Davey09/NEMA23-Stepper-Controller-PCB/images/pcb_render_isometric_bottom.png

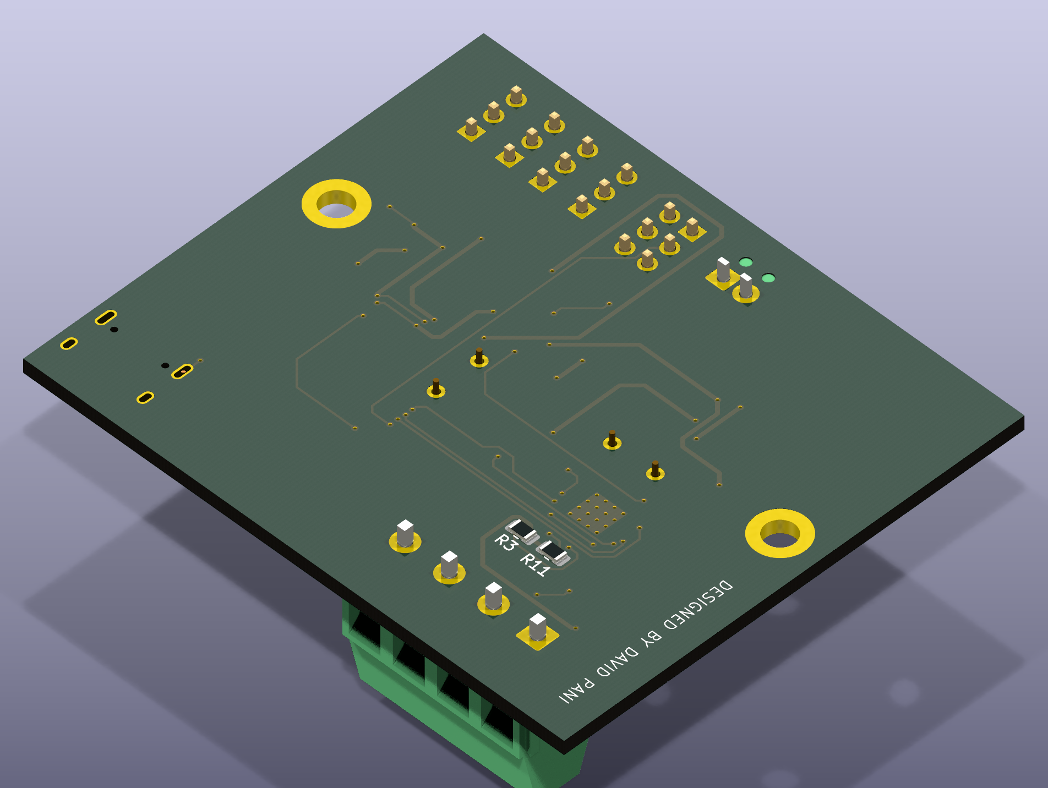
images/pcb_render_isometric_bottom.png
