Davey09/NEMA23-Stepper-Controller-PCB/fabrication/BOM.csv

Reference | Value | Footprint | Qty
C1-C3,C6,C9-C12,C14,C15,C18 | 100nF | Capacitor_SMD:C_0805_2012Metric | 11
C4,C5 | 22pF | Capacitor_SMD:C_0805_2012Metric | 2
C7,C8,C16,C17 | 4.7uF | Capacitor_Tantalum_SMD:CP_EIA-3528-15_AVX-H | 4
C13 | 100μF | Capacitor_SMD:C_0805_2012Metric | 1
C19-C22 | 160nF | Capacitor_SMD:C_0805_2012Metric | 4
D1 | US1G | Diode_SMD:D_SMA | 1
D2,D3 | LED | LED_SMD:LED_0805_2012Metric | 2
D5 | RX | LED_SMD:LED_0805_2012Metric | 1
D6 | PWR | LED_SMD:LED_0805_2012Metric | 1
D7 | TX | LED_SMD:LED_0805_2012Metric | 1
J2 | ISP | Connector_PinHeader_2.54mm:PinHeader_2x03_P2.54mm_Vertical | 1
J3 | DIGITAL_1 | Connector_PinHeader_2.54mm:PinHeader_1x03_P2.54mm_Vertical | 1
J4 | DIGITAL_2 | Connector_PinHeader_2.54mm:PinHeader_1x03_P2.54mm_Vertical | 1
J5 | ANALOG_1 | Connector_PinHeader_2.54mm:PinHeader_1x03_P2.54mm_Vertical | 1
J6 | Power input | TerminalBlock_Phoenix:TerminalBlock_Phoenix_MPT-0,5-2-2.54_1x02_P2.54mm_Horizontal | 1
J7 | Stepper_motor | TerminalBlock_Phoenix:TerminalBlock_Phoenix_MKDS-1,5-4_1x04_P5.00mm_Horizontal | 1
J8 | ANALOG_2 | Connector_PinHeader_2.54mm:PinHeader_1x03_P2.54mm_Vertical | 1
J9 | USB_C_Receptacle_USB2.0_16P | Connector_USB:USB_C_Receptacle_XKB_U262-16XN-4BVC11 | 1
R1,R2,R16 | 10kΩ | Resistor_SMD:R_0805_2012Metric | 3
R3,R11 | 0.11Ω | Resistor_SMD:R_0805_2012Metric | 2
R4,R5,R12-R15 | 1kΩ | Resistor_SMD:R_0805_2012Metric | 6
R6-R8 | 300Ω | Resistor_SMD:R_0805_2012Metric | 3
R9,R10 | 5.1kΩ | Resistor_SMD:R_0805_2012Metric | 2
R17 | 6.2kΩ | Resistor_SMD:R_0805_2012Metric | 1
SW1 | SW_Push | Button_Switch_SMD:SW_SPST_Omron_B3FS-100xP | 1
U1 | ATmega328-A | Package_QFP:TQFP-32_7x7mm_P0.8mm | 1
U2 | NCP1117-5.0_SOT223 | Package_TO_SOT_SMD:SOT-223-3_TabPin2 | 1
U3 | FT232RL | Package_SO:SSOP-28_5.3x10.2mm_P0.65mm | 1
U5 | TMC2209-LA | Package_DFN_QFN:VQFN-28-1EP_5x5mm_P0.5mm_EP3.7x3.7mm_ThermalVias | 1
Y1,Y2 | 16MHz | Crystal:Crystal_HC49-4H_Vertical | 2
