Davey09/NEMA23-Stepper-Controller-PCB/docs/Schematic.pdf

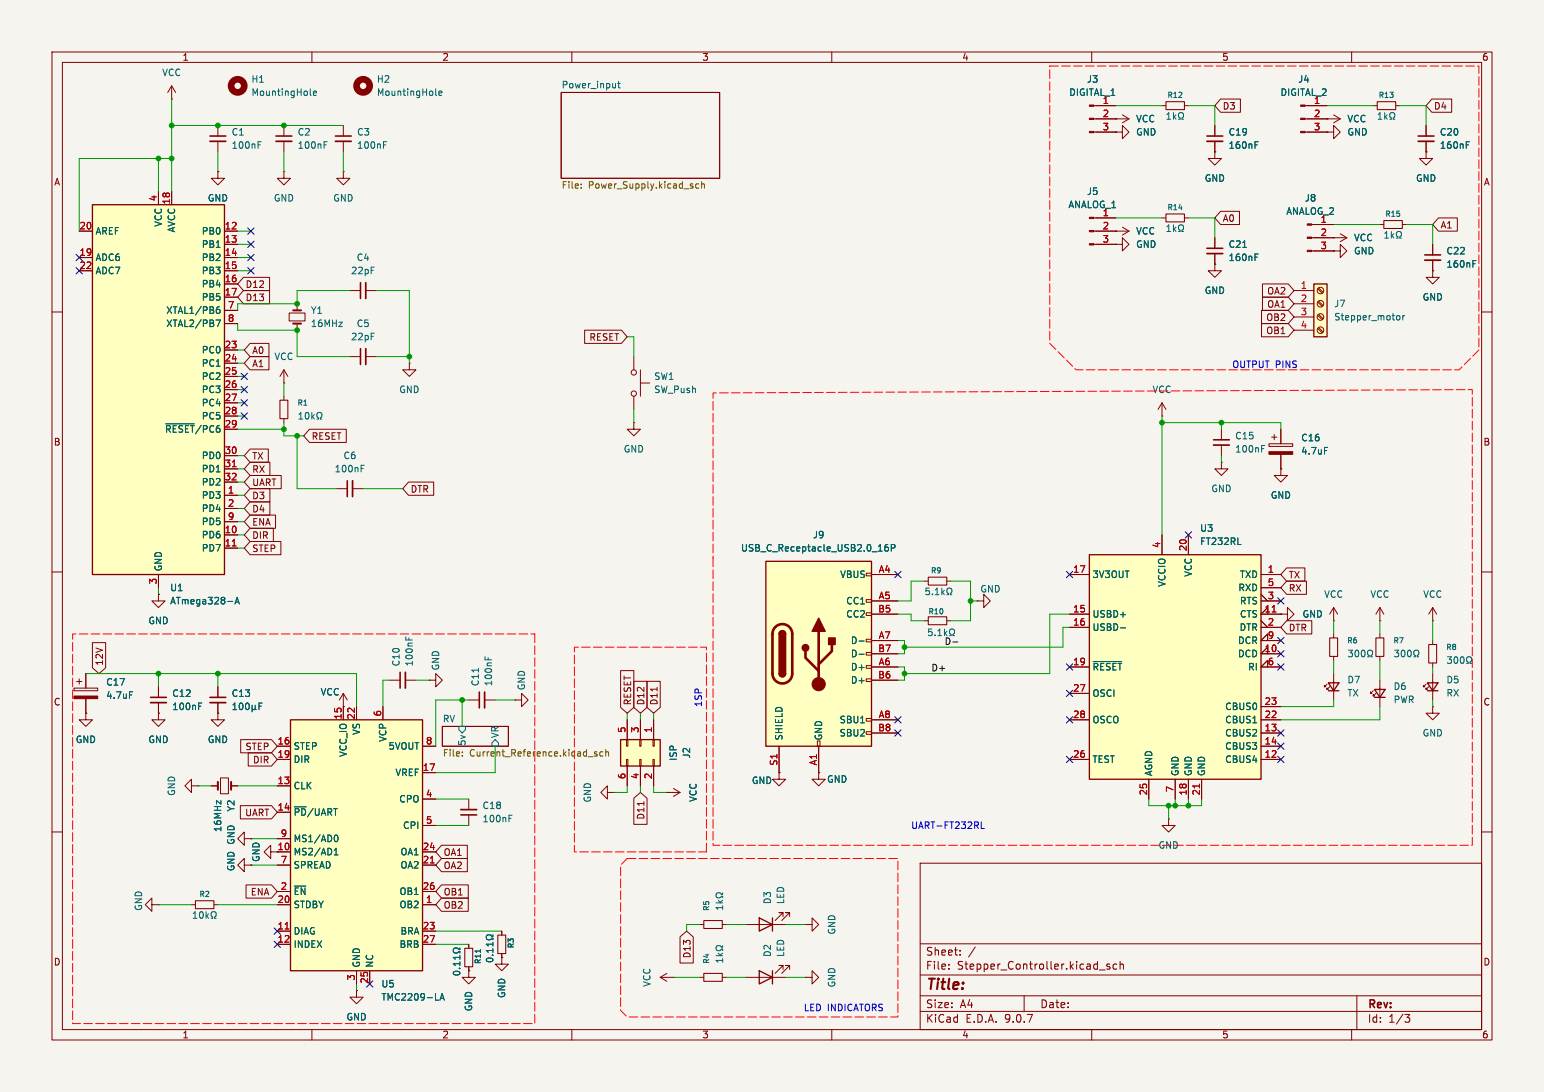
[picture p5: page 1]

100nFH1 MountingHole VCC GND GND

3 AVCC 18 PB0 12 PB1 13 PB2 14 PB3 15 PB4 16 PB5 17 XTAL1/PB6 7 XTAL2/PB7 8 PC0 23 PC1 24 PC2 25 PC3 26 PC4 27 PC5 28 ~{RESET}/PC629 PD0 30 PD1 31 PD2 32 PD3 1 PD4 2 PD5 9 PD6 10 PD7 11 R3 R11 þÿ0.11© þÿ0.11© VCC ISPJ2

7 VCC 20 GND 18 GND 21 TXD 1 RXD 5 RTS 3 CTS 11 DTR 2 DCR 9 DCD 10 RI 6 CBUS0 23 CBUS1 22 CBUS2 13 CBUS3 14 CBUS4 12 U3 FT232RL C16

7 VCC 20 GND 18 GND 21 TXD 1 RXD 5 RTS 3 CTS 11 DTR 2 DCR 9 DCD 10 RI 6 CBUS0 23 CBUS1 22 CBUS2 13 CBUS3 14 CBUS4 12 C16

Id: 1/3 Title: File: Stepper_Controller.kicad_sch Sheet: /

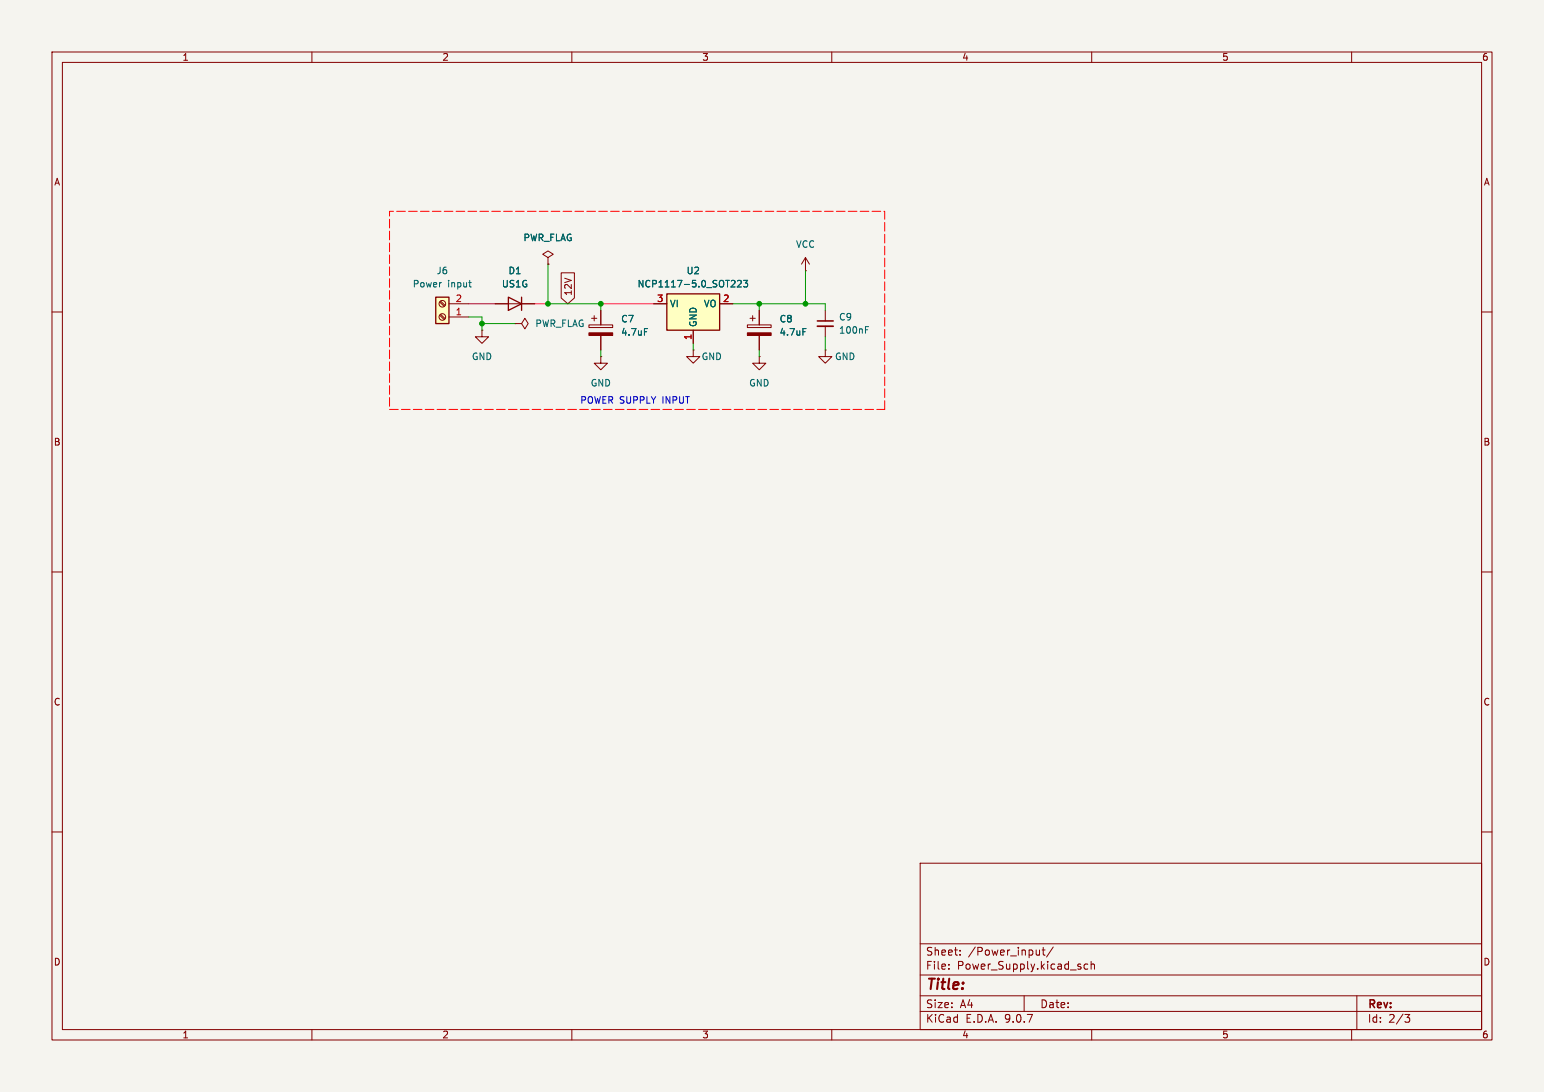
[picture p6: page 2]

Id: 2/3 Title: File: Power_Supply.kicad_sch Sheet: /Power_input/

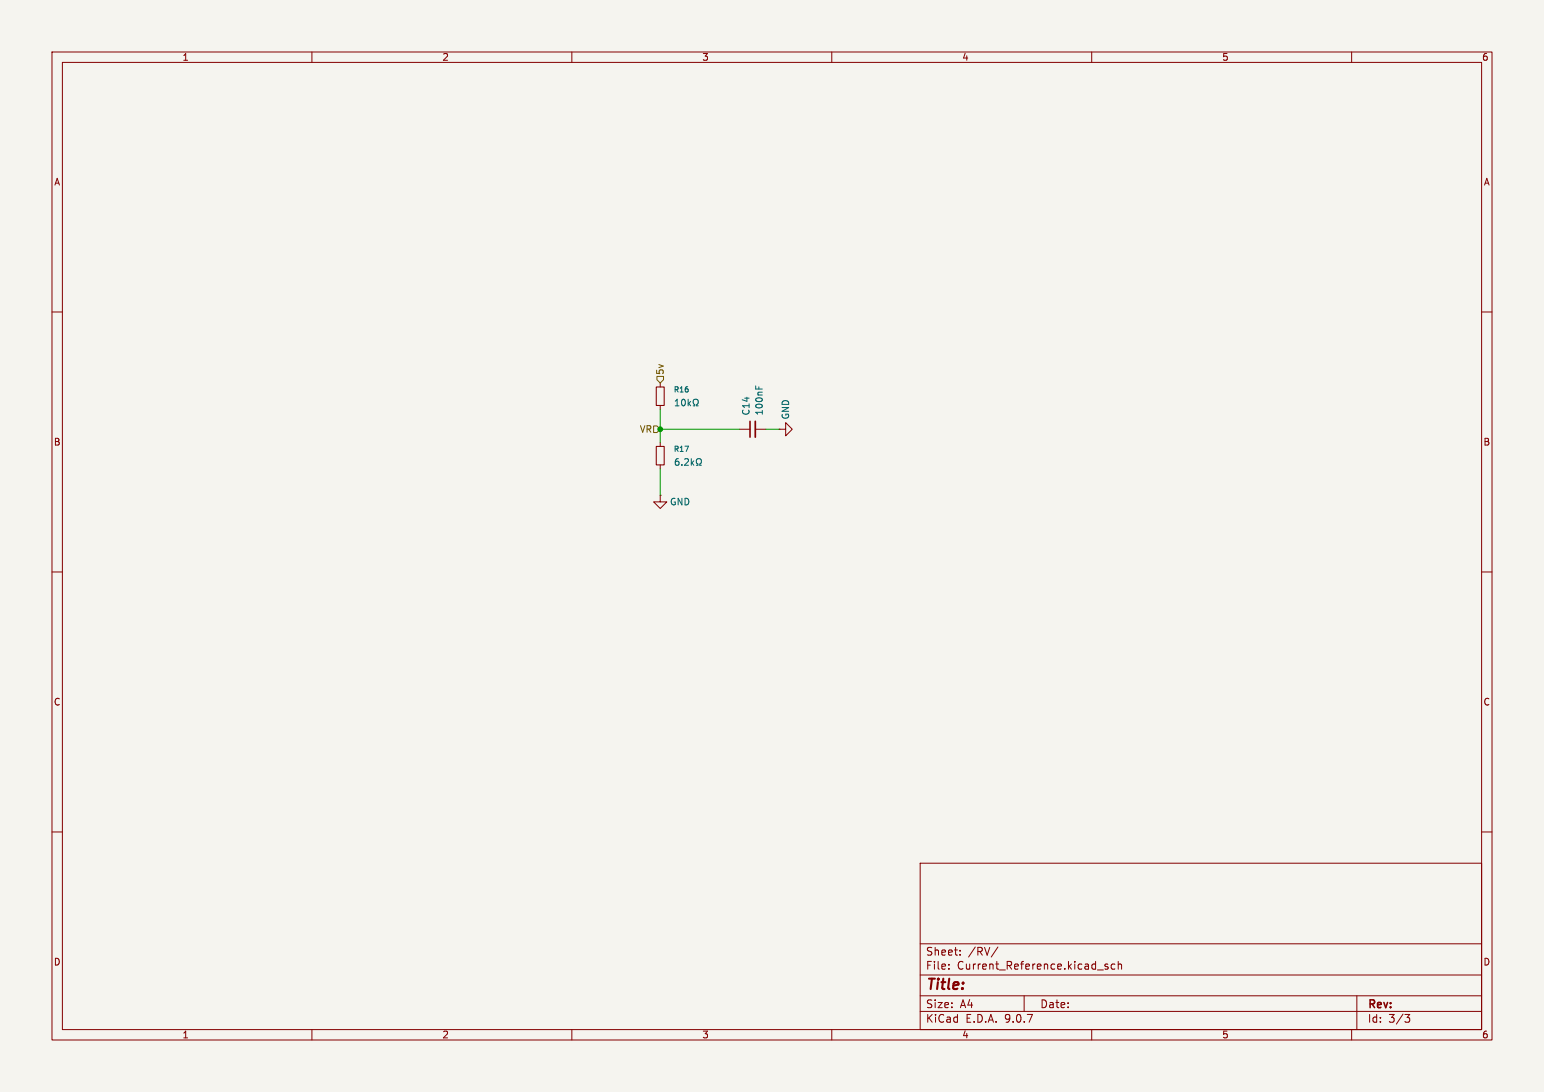
[picture p7: page 3]

Id: 3/3 Title: File: Current_Reference.kicad_sch Sheet: /RV/ GND
