Davey09/NEMA23-Stepper-Controller-PCB/hardware/Stepper_Controller.kicad_pcb

## KiCad design hardware/Stepper_Controller.kicad_pcb (2026-11-10)

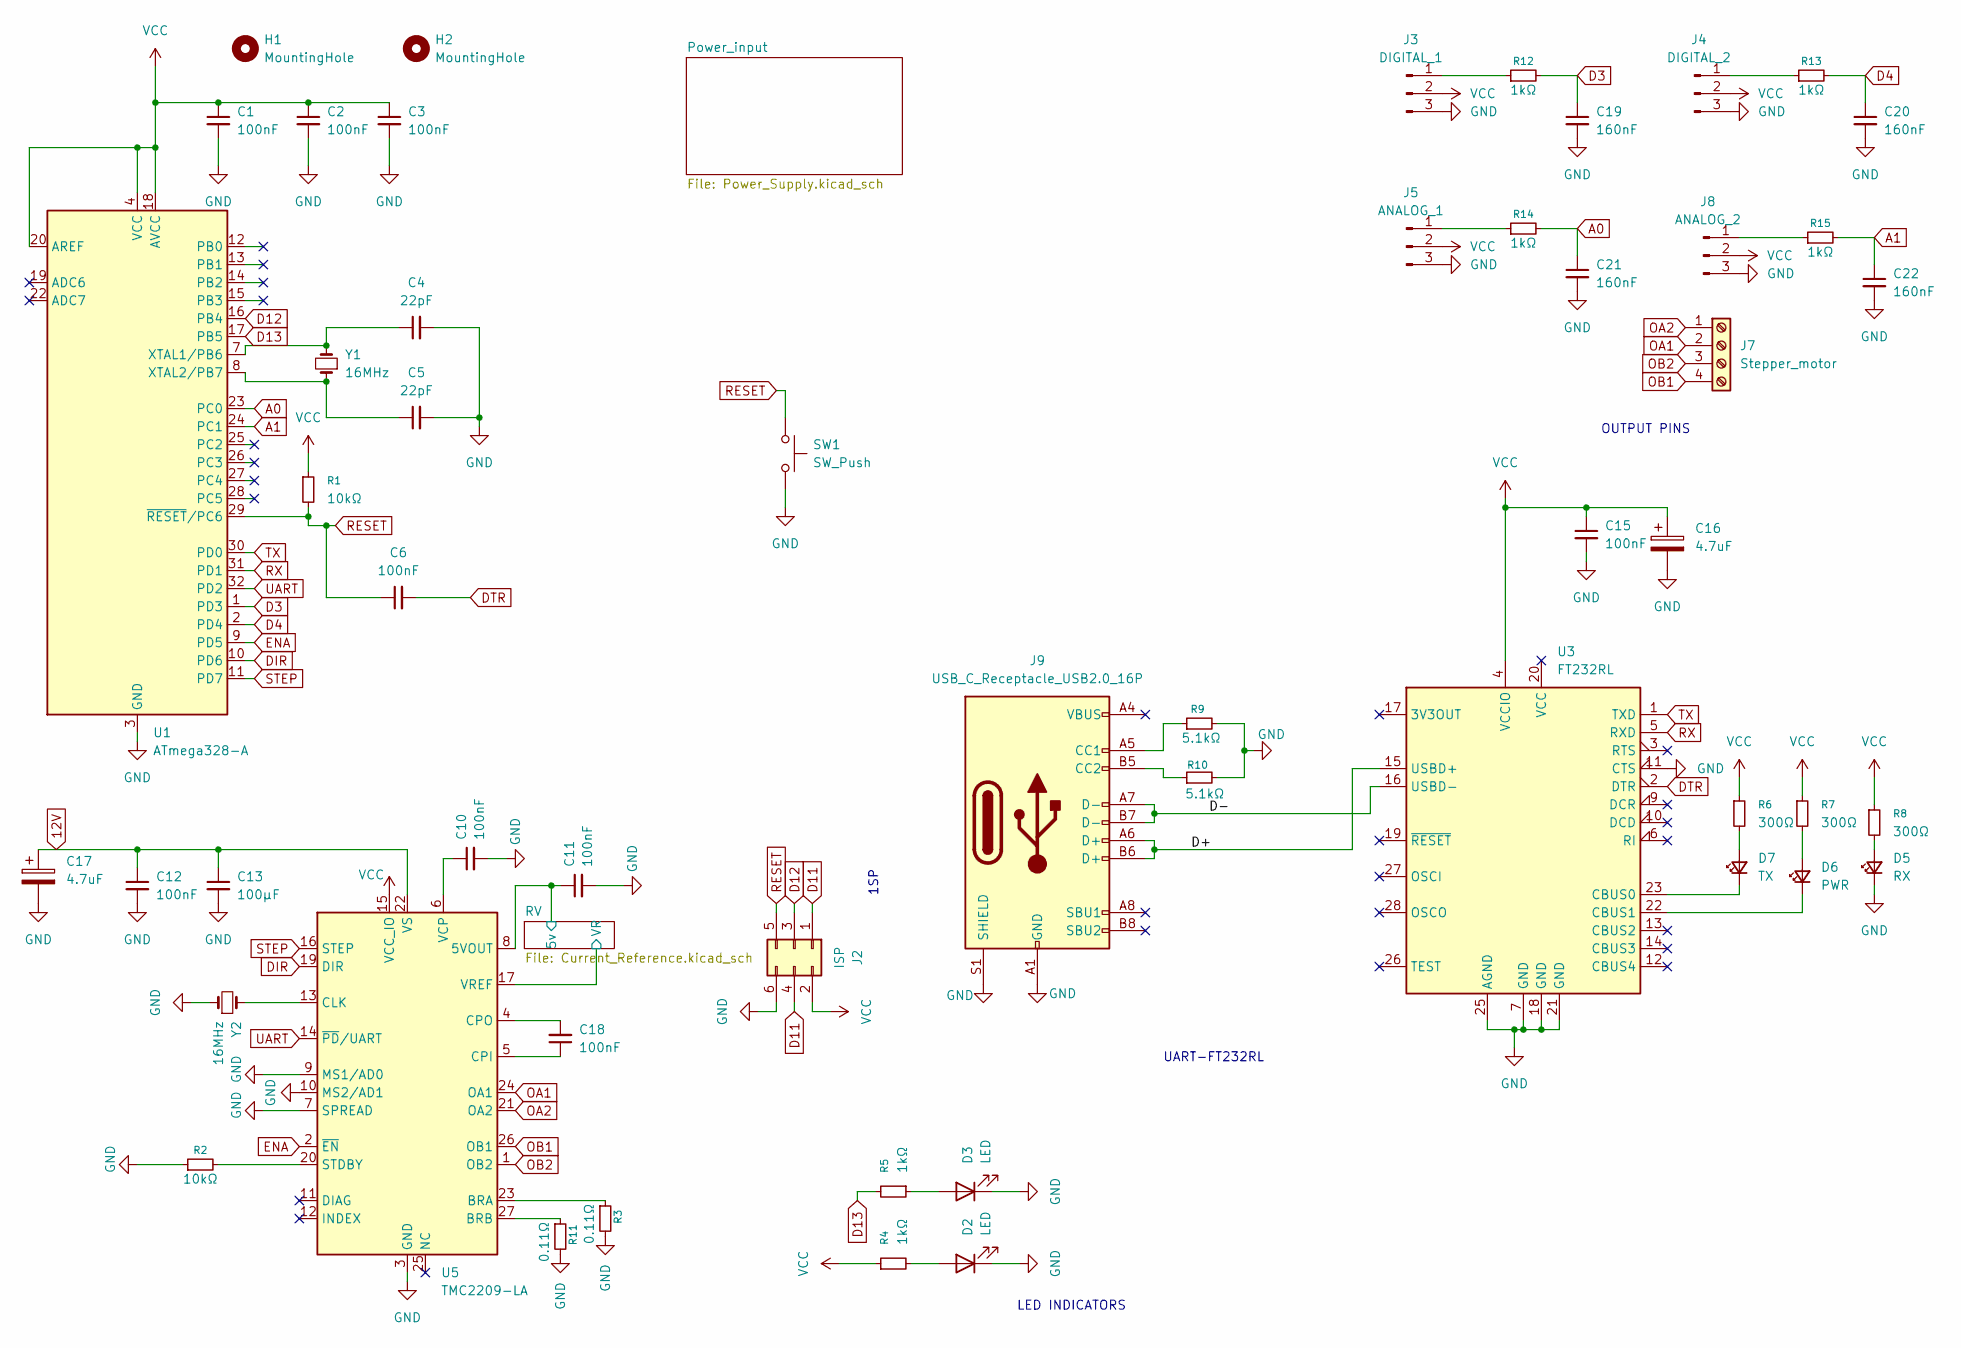
[picture p8: schematic Stepper_Controller.kicad_sch]

Parts:
C1, C2, C3, C6, C10, C11, C12, C15, C18: 100nF; C_0805_2012Metric
C4, C5: 22pF; C_0805_2012Metric
C13: 100μF; C_0805_2012Metric
C16, C17: 4.7uF; CP_EIA-3528-15_AVX-H
C19, C20, C21, C22: 160nF; C_0805_2012Metric
D2, D3: LED; LED_0805_2012Metric
D5: RX; LED_0805_2012Metric
D6: PWR; LED_0805_2012Metric
D7: TX; LED_0805_2012Metric
H1, H2: MountingHole; MountingHole_3.2mm_M3_DIN965_Pad
J2: ISP; PinHeader_2x03_P2.54mm_Vertical
J3: DIGITAL_1; PinHeader_1x03_P2.54mm_Vertical
J4: DIGITAL_2; PinHeader_1x03_P2.54mm_Vertical
J5: ANALOG_1; PinHeader_1x03_P2.54mm_Vertical
J7: Stepper_motor; TerminalBlock_Phoenix_MKDS-1,5-4_1x04_P5.00mm_Horizontal
J8: ANALOG_2; PinHeader_1x03_P2.54mm_Vertical
J9: USB_C_Receptacle_USB2.0_16P; USB_C_Receptacle_XKB_U262-16XN-4BVC11
R1, R2: 10kΩ; R_0805_2012Metric
R3, R11: 0.11Ω; R_0805_2012Metric
R4, R5, R12, R13, R14, R15: 1kΩ; R_0805_2012Metric
R6, R7, R8: 300Ω; R_0805_2012Metric
R9, R10: 5.1kΩ; R_0805_2012Metric
SW1: SW_Push; SW_SPST_Omron_B3FS-100xP
U1: ATmega328-A; TQFP-32_7x7mm_P0.8mm
U3: FT232RL; SSOP-28_5.3x10.2mm_P0.65mm
U5: TMC2209-LA; VQFN-28-1EP_5x5mm_P0.5mm_EP3.7x3.7mm_ThermalVias
Y1, Y2: 16MHz; Crystal_HC49-4H_Vertical

Connections:
12V: C12.1, C13.1, C17.1, U5.22 (VS), U5.28 (VS); also elsewhere on the board
/D+: J9.A6 (D+), J9.B6 (D+), U3.15 (USBD+)
/D-: J9.A7 (D-), J9.B7 (D-), U3.16 (USBD-)
/RV/5v: C11.1, U5.8 (5VOUT); also elsewhere on the board
/RV/VR: U5.17 (VREF); also elsewhere on the board
A0: C21.1, R14.2, U1.23 (PC0)
A1: C22.1, R15.2, U1.24 (PC1)
D3: C19.1, R12.2, U1.1 (PD3)
D4: C20.1, R13.2, U1.2 (PD4)
D11: J2.1, J2.4
D12: J2.3, U1.16 (PB4)
D13: R5.2, U1.17 (PB5)
DIR: U1.10 (PD6), U5.19 (DIR)
DTR: C6.2, U3.2 (DTR)
ENA: U1.9 (PD5), U5.2 (~EN)
GND: C1.2, C2.2, C3.2, C4.2, C5.2, C10.2, C11.2, C12.2, C13.2, C15.2, C16.2, C17.2, C19.2, C20.2, C21.2, C22.2, D2.1 (K), D3.1 (K), D5.1 (K), J2.6, J3.3, J4.3, J5.3, J8.3, J9.A1 (GND), J9.A12 (GND), J9.B1 (GND), J9.B12 (GND), J9.S1 (SHIELD), R2.1, R3.2, R9.2, R10.2, R11.2, SW1.2, U1.3 (GND), U1.5 (GND), U1.21 (GND), U3.7 (GND), U3.11 (CTS), U3.18 (GND), U3.21 (GND), U3.25 (AGND), U5.3 (GND), U5.7 (SPREAD), U5.9 (MS1/AD0), U5.10 (MS2/AD1), U5.18 (GND), U5.29 (GND), Y2.1; also elsewhere on the board
unnamed: D2.2 (A), R4.2
unnamed: D3.2 (A), R5.1
unnamed: D5.2 (A), R8.2
unnamed: D6.2 (A), R7.2
unnamed: D6.1 (K), U3.22 (CBUS1)
unnamed: D7.2 (A), R6.2
unnamed: D7.1 (K), U3.23 (CBUS0)
unnamed: J3.1, R12.1
unnamed: J4.1, R13.1
unnamed: J5.1, R14.1
unnamed: J8.1, R15.1
unnamed: J9.A5 (CC1), R9.1
unnamed: J9.B5 (CC2), R10.1
unnamed: C4.1, U1.7 (XTAL1/PB6), Y1.2
unnamed: C5.1, U1.8 (XTAL2/PB7), Y1.1
unnamed: R3.1, U5.23 (BRA)
unnamed: R11.1, U5.27 (BRB)
unnamed: U5.13 (CLK), Y2.2
unnamed: C18.1, U5.5 (CPI)
unnamed: C18.2, U5.4 (CPO)
unnamed: R2.2, U5.20 (STDBY)
unnamed: C10.1, U5.6 (VCP)
OA1: J7.2, U5.24 (OA1)
OA2: J7.1, U5.21 (OA2)
OB1: J7.4, U5.26 (OB1)
OB2: J7.3, U5.1 (OB2)
RESET: C6.1, J2.5, R1.2, SW1.1, U1.29 (~RESET/PC6)
RX: U1.31 (PD1), U3.5 (RXD)
STEP: U1.11 (PD7), U5.16 (STEP)
TX: U1.30 (PD0), U3.1 (TXD)
UART: U1.32 (PD2), U5.14 (~PD/UART)
VCC: C1.1, C2.1, C3.1, C15.1, C16.1, J2.2, J3.2, J4.2, J5.2, J8.2, R1.1, R4.1, R6.1, R7.1, R8.1, U1.4 (VCC), U1.6 (VCC), U1.18 (AVCC), U1.20 (AREF), U3.4 (VCCIO), U5.15 (VCC_IO); also elsewhere on the board

Notes on the sheet:
OUTPUT PINS
LED INDICATORS
1SP
UART-FT232RL

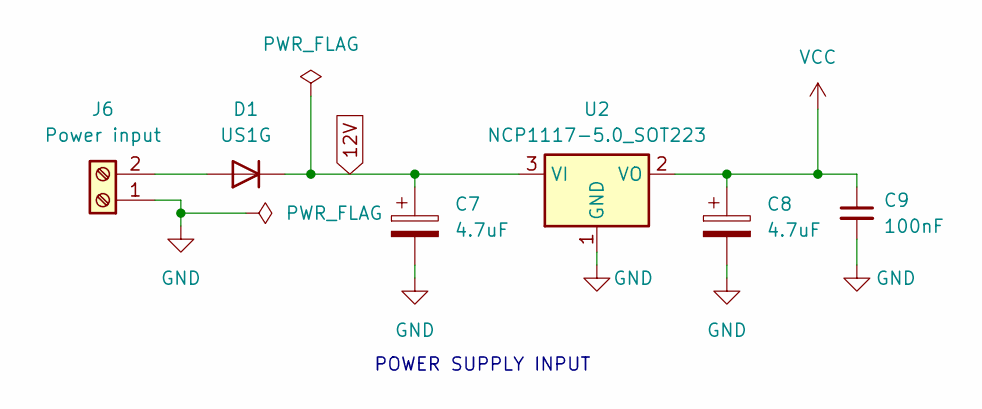
[picture p9: schematic Power_Supply.kicad_sch]

Parts:
C7, C8: 4.7uF; CP_EIA-3528-15_AVX-H
C9: 100nF; C_0805_2012Metric
D1: US1G; D_SMA
J6: Power input; TerminalBlock_Phoenix_MPT-0,5-2-2.54_1x02_P2.54mm_Horizontal
U2: NCP1117-5.0_SOT223; SOT-223-3_TabPin2

Connections:
12V: C7.1, D1.1 (K), U2.3 (VI); also elsewhere on the board
GND: C7.2, C8.2, C9.2, J6.1, U2.1 (GND); also elsewhere on the board
unnamed: D1.2 (A), J6.2
VCC: C8.1, C9.1, U2.2 (VO); also elsewhere on the board

Notes on the sheet:
POWER SUPPLY INPUT

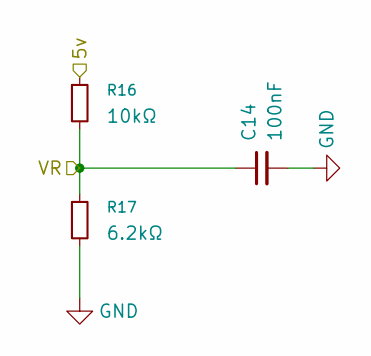
[picture p10: schematic Current_Reference.kicad_sch]

Parts:
C14: 100nF; C_0805_2012Metric
R16: 10kΩ; R_0805_2012Metric
R17: 6.2kΩ; R_0805_2012Metric

Connections:
/RV/5v: R16.1; also elsewhere on the board
/RV/VR: C14.1, R16.2, R17.1; also elsewhere on the board
GND: C14.2, R17.2; also elsewhere on the board

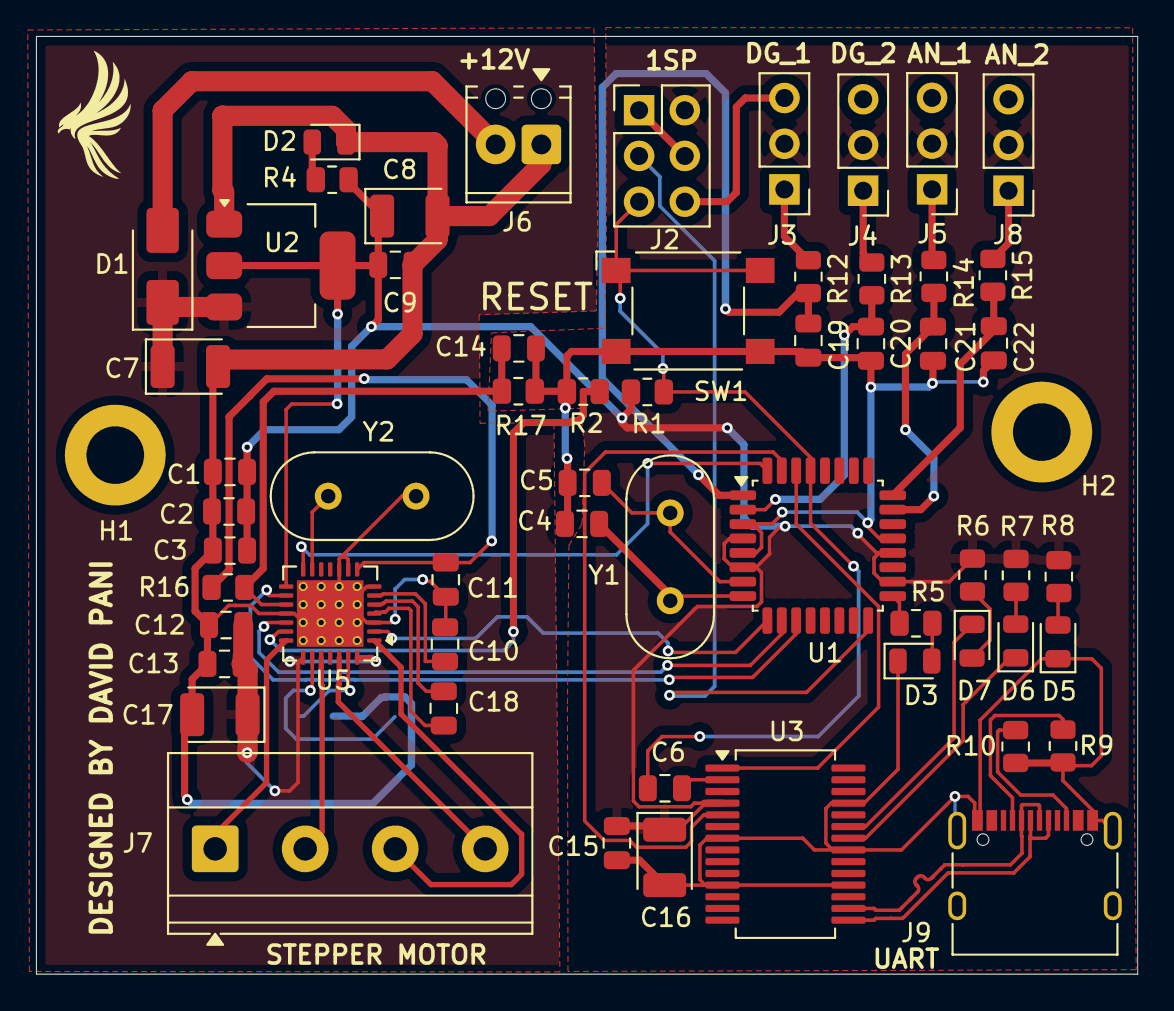
[picture p11: board Stepper_Controller.kicad_pcb from above]

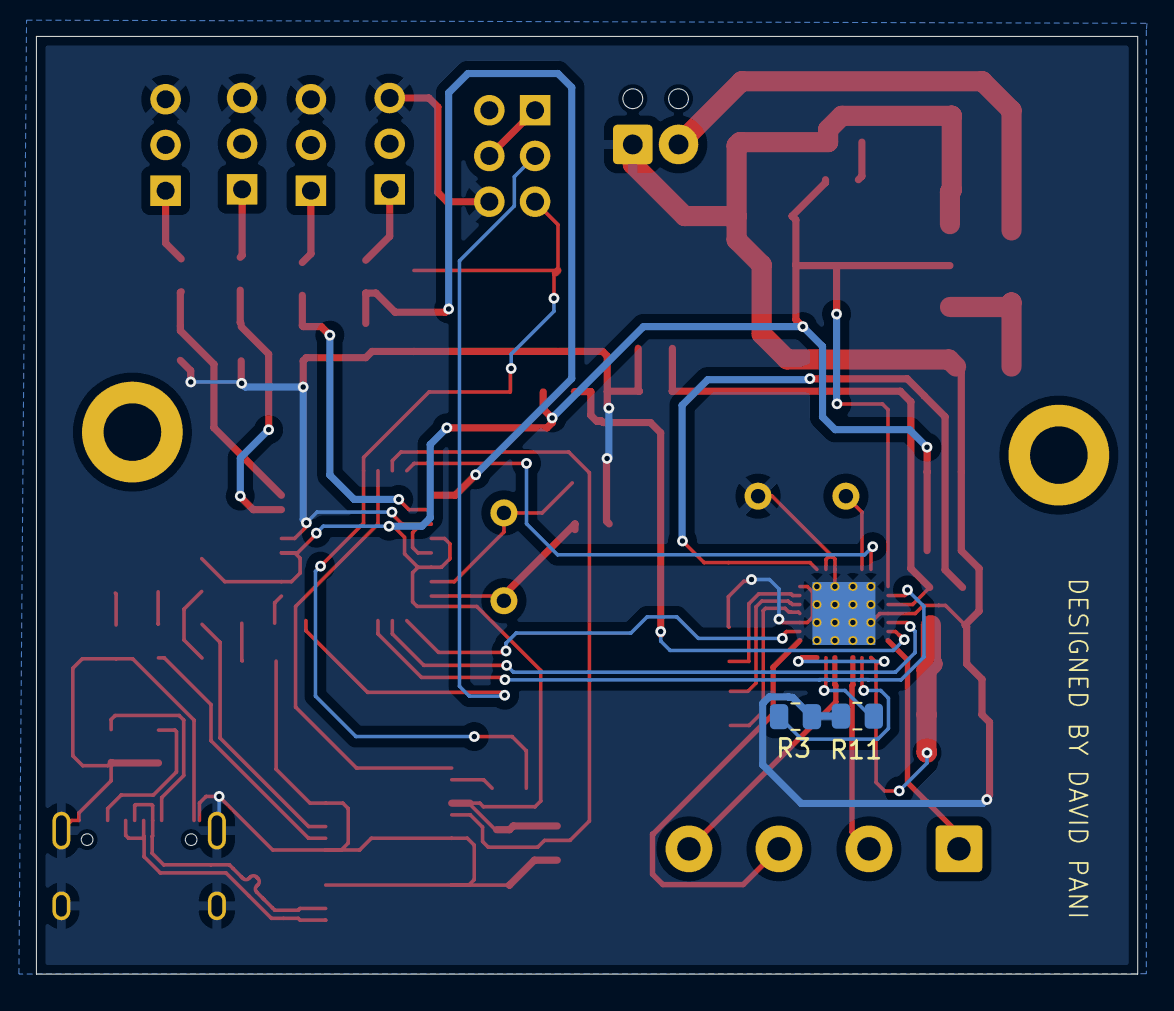
[picture p12: board Stepper_Controller.kicad_pcb from below]

Board: 2 copper layers, 61.2 x 52.1 mm, 62 parts (2 on the bottom side), 49 nets.
